cmetramexs/50.002_COMPSTRUCT/work/planAhead/final/final.runs/synth_1/.xst.begin.rst

<?xml version="1.0"?>
<ProcessHandle Version="1" Minor="0">
    <Process Command="xst" Owner="Celine Yee" Host="DESKTOP-Q9H0DJ1" Pid="15712">
    </Process>
</ProcessHandle>
