cmetramexs/50.002_COMPSTRUCT/work/planAhead/final/final.runs/impl_1/.ngdbuild.begin.rst

<?xml version="1.0"?>
<ProcessHandle Version="1" Minor="0">
    <Process Command="ngdbuild" Owner="Celine Yee" Host="DESKTOP-Q9H0DJ1" Pid="7588">
    </Process>
</ProcessHandle>
