cmetramexs/50.002_COMPSTRUCT/(commit log)

2018-12-08 added delay for out of bounds
    [mojo_top_0_routed_pad.csv]
2018-12-12 SUBC function added
    [mojo_top_0_routed_pad.csv]
